unixvoid/squidgrip/hardware/manufacturing/squidgrip_v1.4_BOM.csv

Comment | Designator | Footprint | LCSC Part Number
4.7uF | C1 | 0805 | C1779
.1uF | C2,C3 | 0805 | C1711
10k | R1,R8 | 0805 | C17414
1k | R5 | 0805 | C17513
5.1k | R6,R7 | 0805 | C27834
2.2k | R9,R10,R11 | 0805 | C17520
CP2102N-A02-GQFN24R | U1 | QFN-24-EP(4x4) | C969151
MBT3904DW1T1G | U2 | SOT-363 | C110150
TLV75733PDRVR | U3 | WSON-6(2x2) | C2868428
