unixvoid/squidgrip/hardware/clamp_design/squidgrip - clamp_upper.step

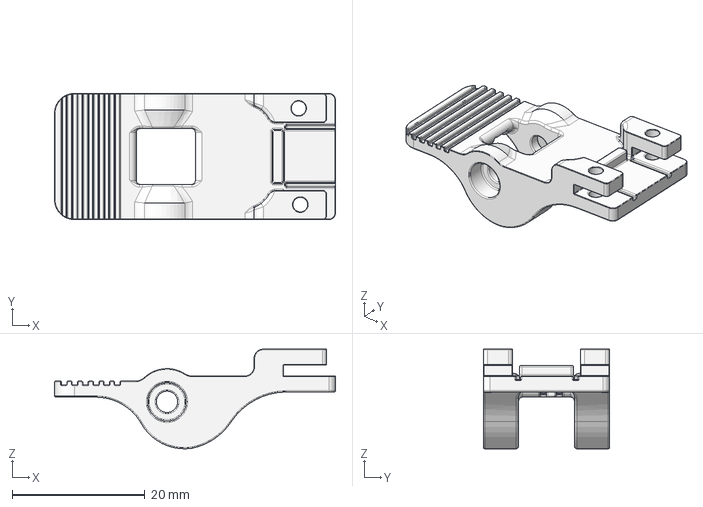
[picture p10: CAD file, 2026-10-14]
hardware/clamp_design/squidgrip - clamp_upper.step
42.3 x 19.0 x 15.0 mm
