unixvoid/squidgrip/hardware/manufacturing/squidgrip.step

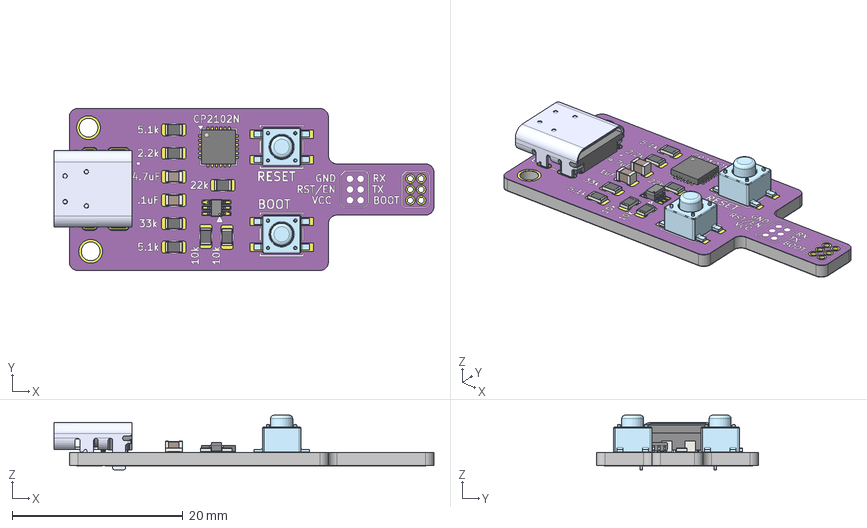
[picture p11: CAD file, 2026-10-14]
hardware/manufacturing/squidgrip.step
44.5 x 19.0 x 6.40 mm
R_0805_2012Metric x 7
USB4085-GF-A_REVB
Y97KT23B0FAFP x 2
C_0805_2012Metric x 2
MBT3904DW1T1G
QFN-24-1EP_4x4mm_P0.5mm_EP2.6x2.6mm
squidgrip_copper
squidgrip_silkscreen
squidgrip_soldermask
squidgrip_PCB
