unixvoid/squidgrip/hardware/clamp_design/squidgrip - clamp_lower.step

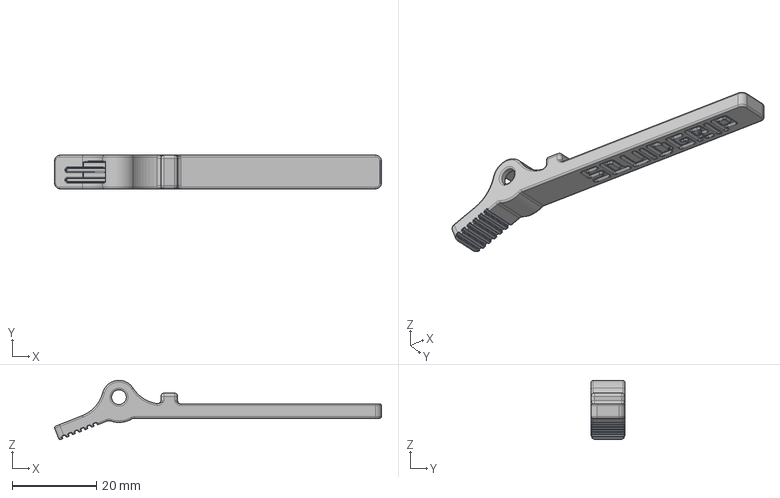
[picture p12: CAD file, 2026-10-14]
hardware/clamp_design/squidgrip - clamp_lower.step
77.6 x 8.00 x 14.1 mm
