unixvoid/squidgrip/hardware/clamp_design/squidgrip - pin.step

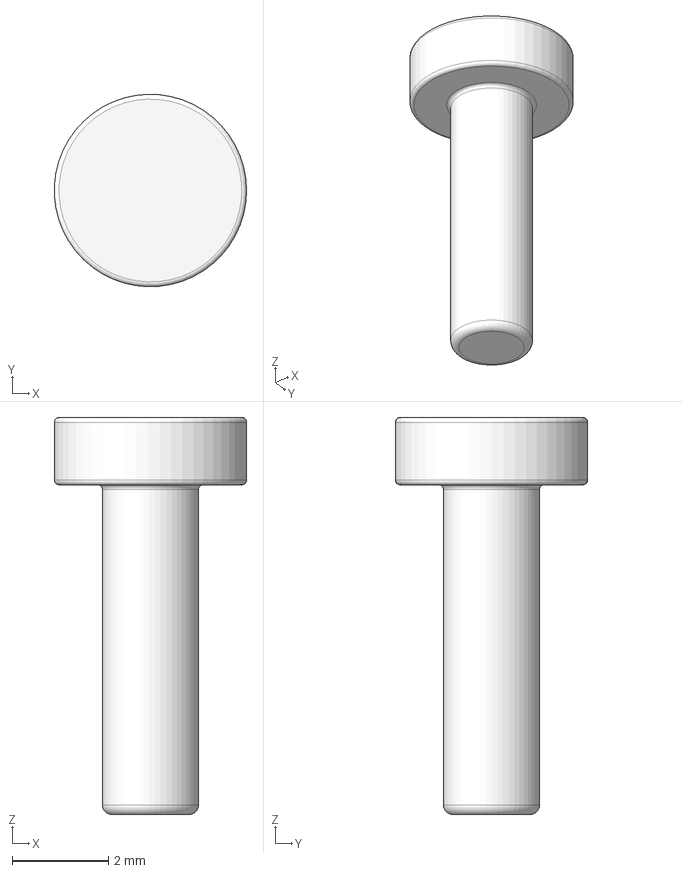
[picture p13: CAD file, 2026-10-14]
hardware/clamp_design/squidgrip - pin.step
4.00 x 4.00 x 8.25 mm
