unixvoid/squidgrip/hardware/squidgrip.kicad_pcb

## KiCad design hardware/squidgrip.kicad_pcb (2026-10-14)

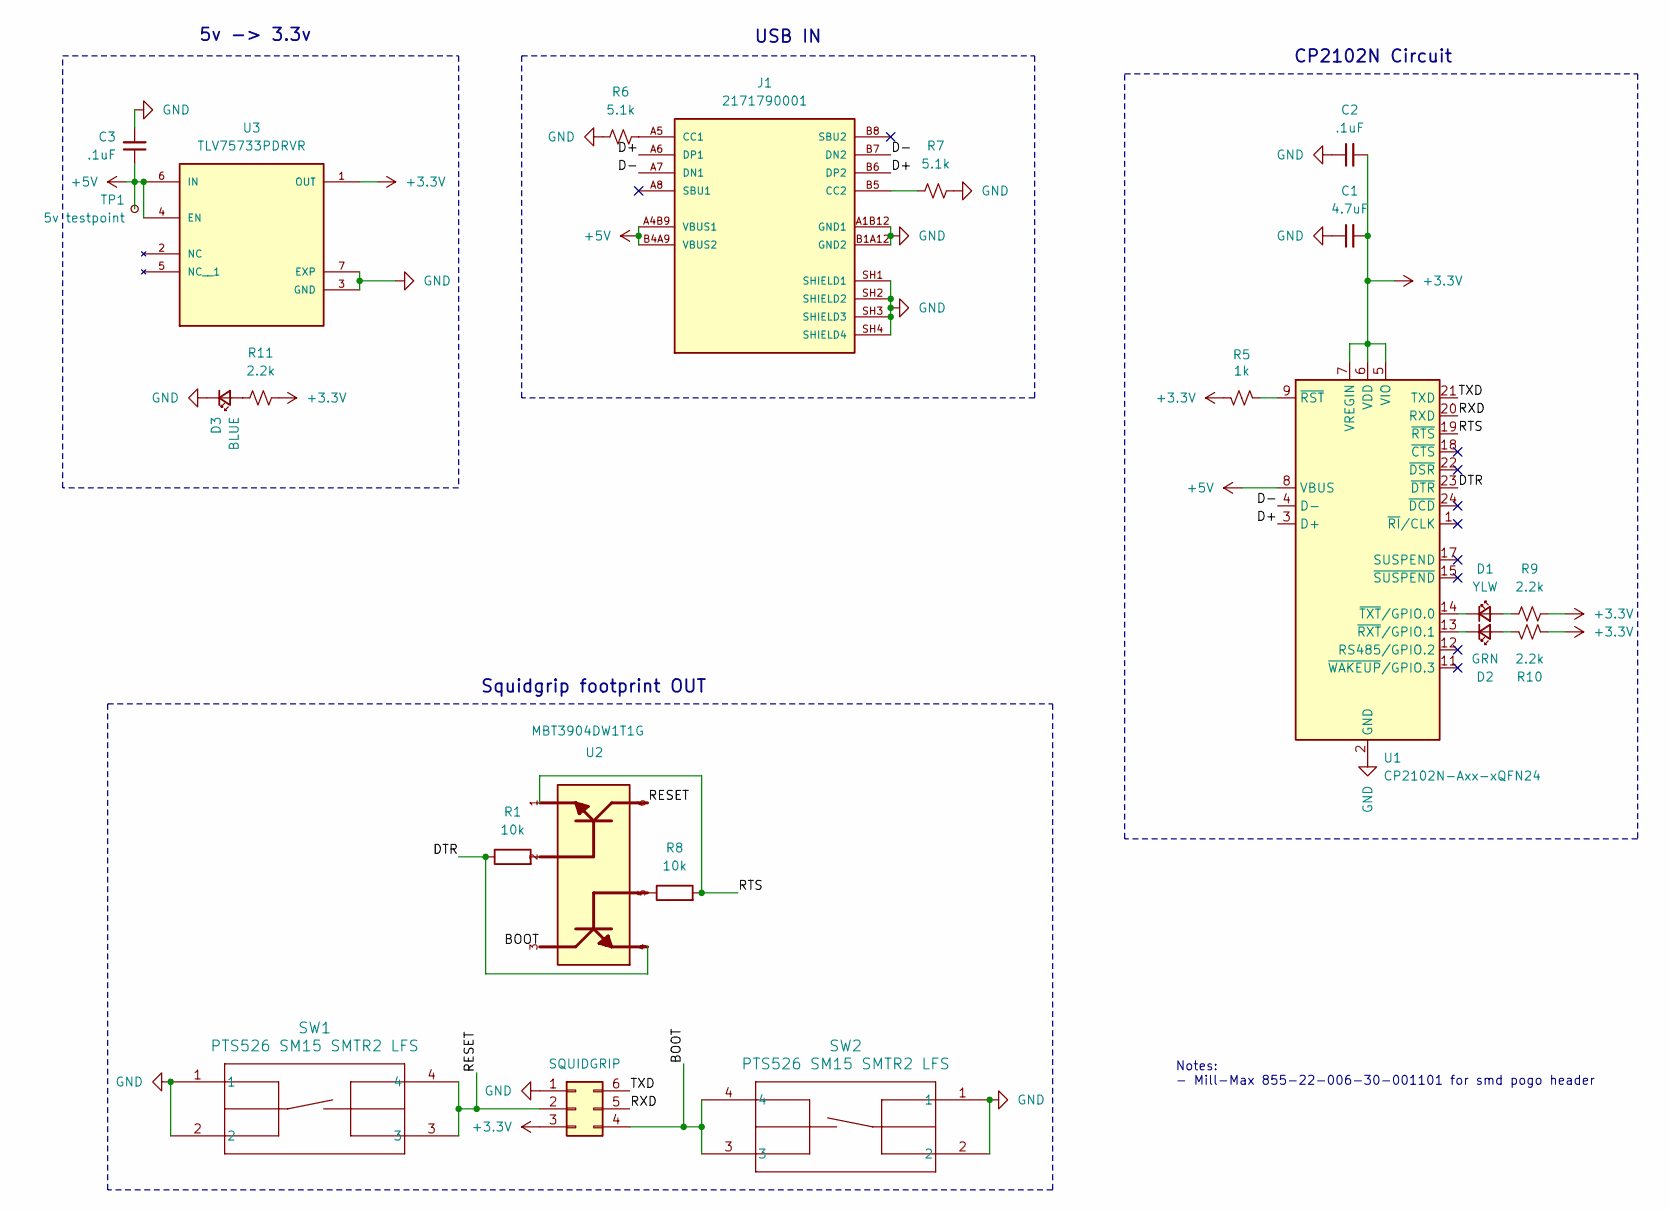
[picture p14: schematic squidgrip.kicad_sch, Squidgrip ESP32 Interface]

Parts:
C1: 4.7uF; C_0805_2012Metric
C2, C3: .1uF; C_0805_2012Metric
D1: YLW; LED_0805_2012Metric
D2: GRN; LED_0805_2012Metric
D3: BLUE; LED_0805_2012Metric
J1: 2171790001; MOLEX_2171790001; PARTREV A1
R1, R8: 10k; R_0805_2012Metric
R5: 1k; R_0805_2012Metric
R6, R7: 5.1k; R_0805_2012Metric
R9, R10, R11: 2.2k; R_0805_2012Metric
SG1: SQUIDGRIP; Untitled
SW1, SW2: PTS526 SM15 SMTR2 LFS; GSPTS004901
TP1: 5v testpoint; TestPoint_Pad_1.0x1.0mm
U1: CP2102N-Axx-xQFN24; QFN-24-1EP_4x4mm_P0.5mm_EP2.6x2.6mm
U2: MBT3904DW1T1G; SOT236
U3: TLV75733PDRVR

Connections:
+3.3V: C1.2, C2.2, R5.1, R9.2, R10.1, R11.2, SG1.3 (3.3v), U1.5 (VIO), U1.6 (VDD), U1.7 (VREGIN), U3.1 (OUT)
+5V: C3.1, J1.A4B9 (VBUS1), J1.B4A9 (VBUS2), TP1.1, U1.8 (VBUS), U3.4 (EN), U3.6 (IN)
/BOOT: SG1.4 (RTS), SW2.3, SW2.4, U2.3
/D+: J1.A6 (DP1), J1.B6 (DP2), U1.3 (D+)
/D-: J1.A7 (DN1), J1.B7 (DN2), U1.4 (D-)
/DTR: R1.1, U1.23 (~DTR), U2.4
/RESET: SG1.2 (DTR), SW1.3, SW1.4, U2.6
/RTS: R8.2, U1.19 (~RTS), U2.1
/RXD: SG1.5 (RXD), U1.20 (RXD)
/TXD: SG1.6 (TXD), U1.21 (TXD)
GND: C1.1, C2.1, C3.2, D3.1 (K), J1.A1B12 (GND1), J1.B1A12 (GND2), J1.SH1 (SHIELD1), J1.SH2 (SHIELD2), J1.SH3 (SHIELD3), J1.SH4 (SHIELD4), R6.1, R7.2, SG1.1 (GND), SW1.1, SW1.2, SW2.1, SW2.2, U1.2 (GND), U1.25 (GND), U3.3 (GND), U3.7 (EXP)
unnamed: D1.2 (A), R9.1
unnamed: D1.1 (K), U1.14 (~TXT/GPIO.0)
unnamed: D2.2 (A), R10.2
unnamed: D2.1 (K), U1.13 (~RXT/GPIO.1)
unnamed: D3.2 (A), R11.1
unnamed: J1.A5 (CC1), R6.2
unnamed: J1.B5 (CC2), R7.1
unnamed: R1.2, U2.2
unnamed: R8.1, U2.5
unnamed: R5.2, U1.9 (~RST)

Notes on the sheet:
5v -> 3.3v
USB IN
CP2102N Circuit
Notes: - Mill-Max 855-22-006-30-001101 for smd pogo header
Squidgrip footprint OUT

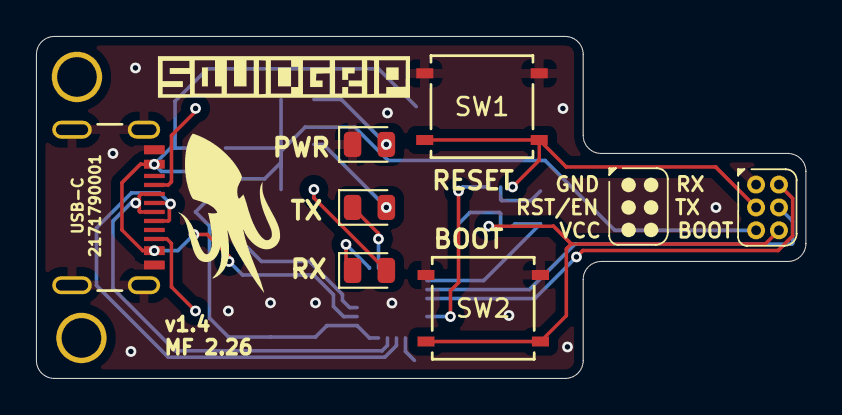
[picture p15: board squidgrip.kicad_pcb from above]

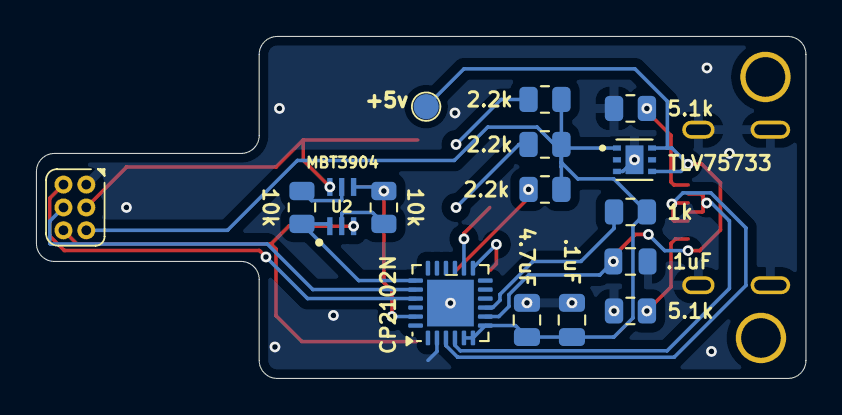
[picture p16: board squidgrip.kicad_pcb from below]

Board: 2 copper layers, 42.8 x 19.0 mm, 22 parts (15 on the bottom side), 21 nets.
